dastcvi/cutdown_hardware/README.md

# cutdown_hardware
Hardware files for the LASP high altitude balloon cutdown controller

## Versions
Different hardware revisions are tagged appropriately and can be downloaded directly from the GitHub Releases tab.
