dastcvi/cutdown_hardware/cutdown_schematic.pdf

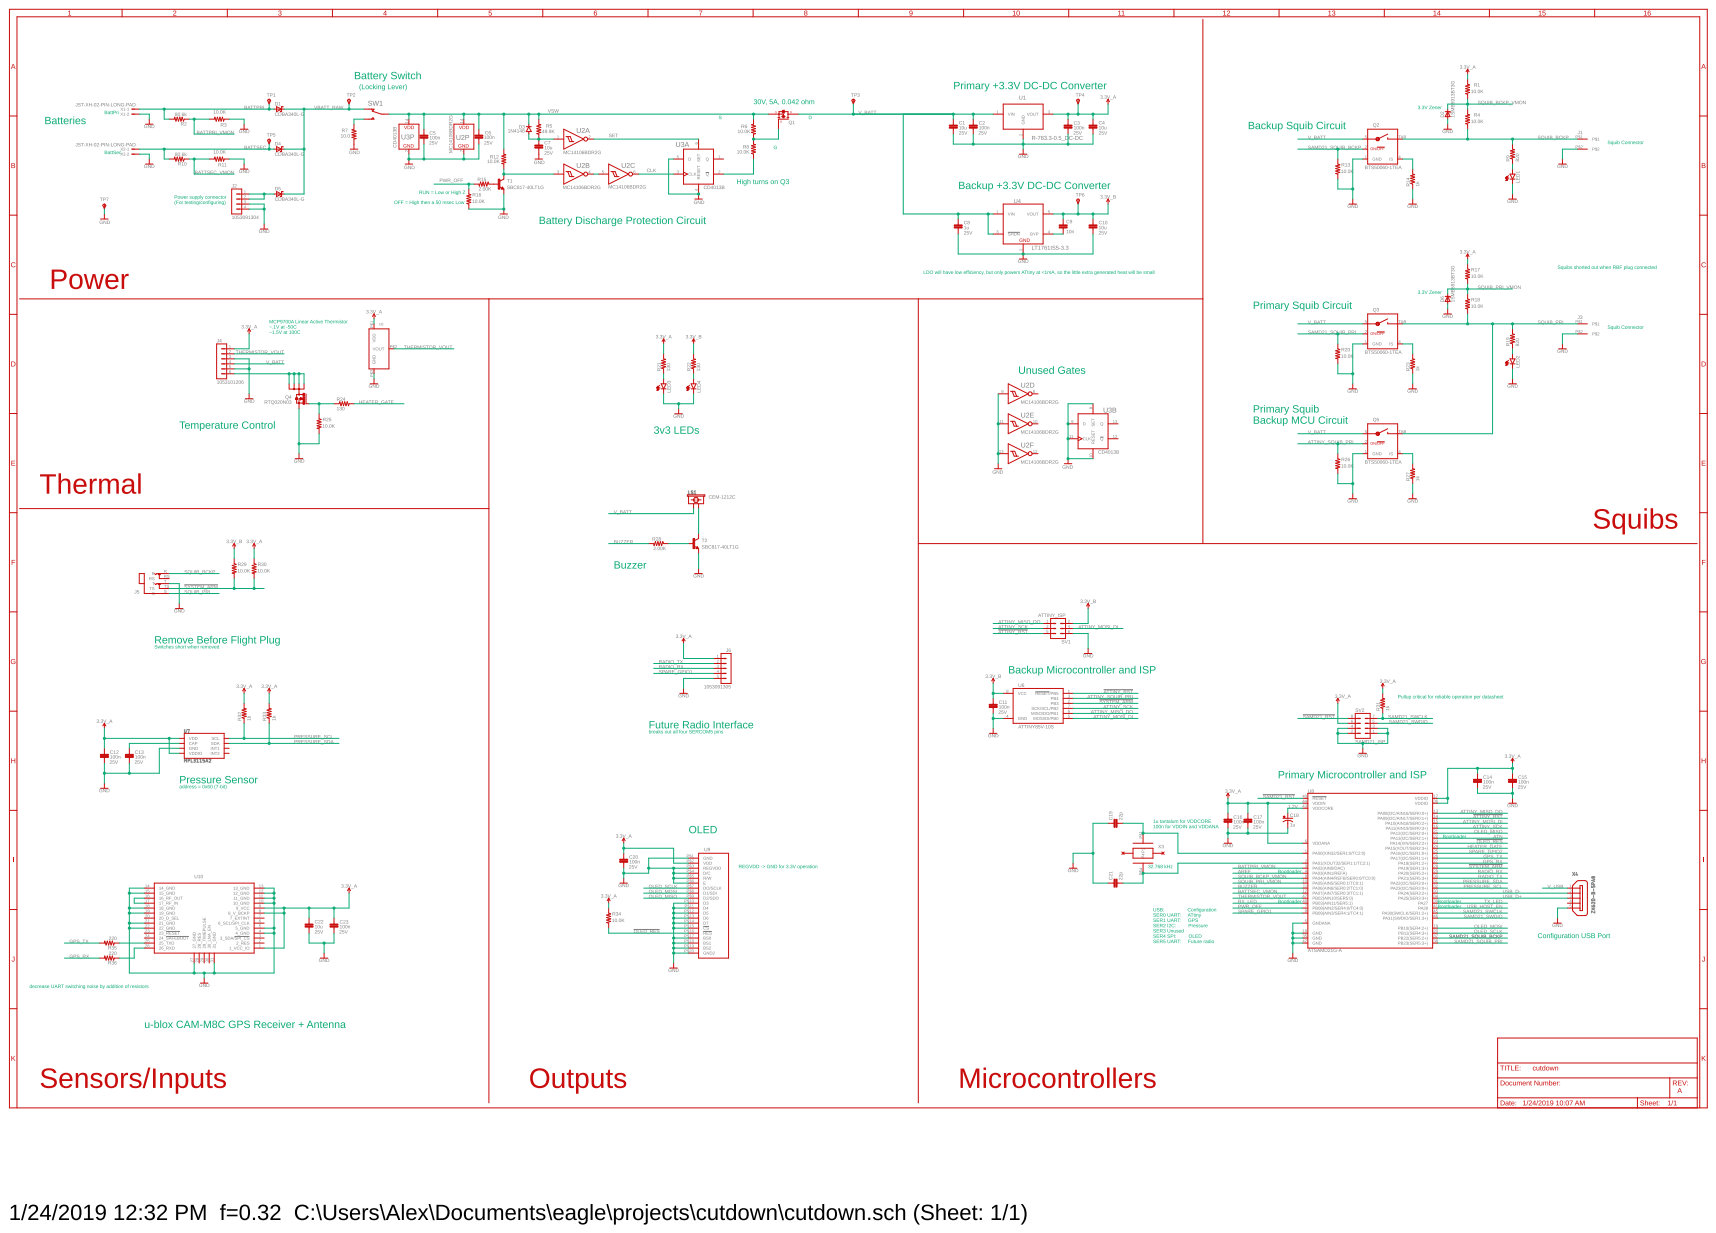
[picture p1: page 1]
