dastcvi/cutdown_hardware/cutdown_layout.pdf

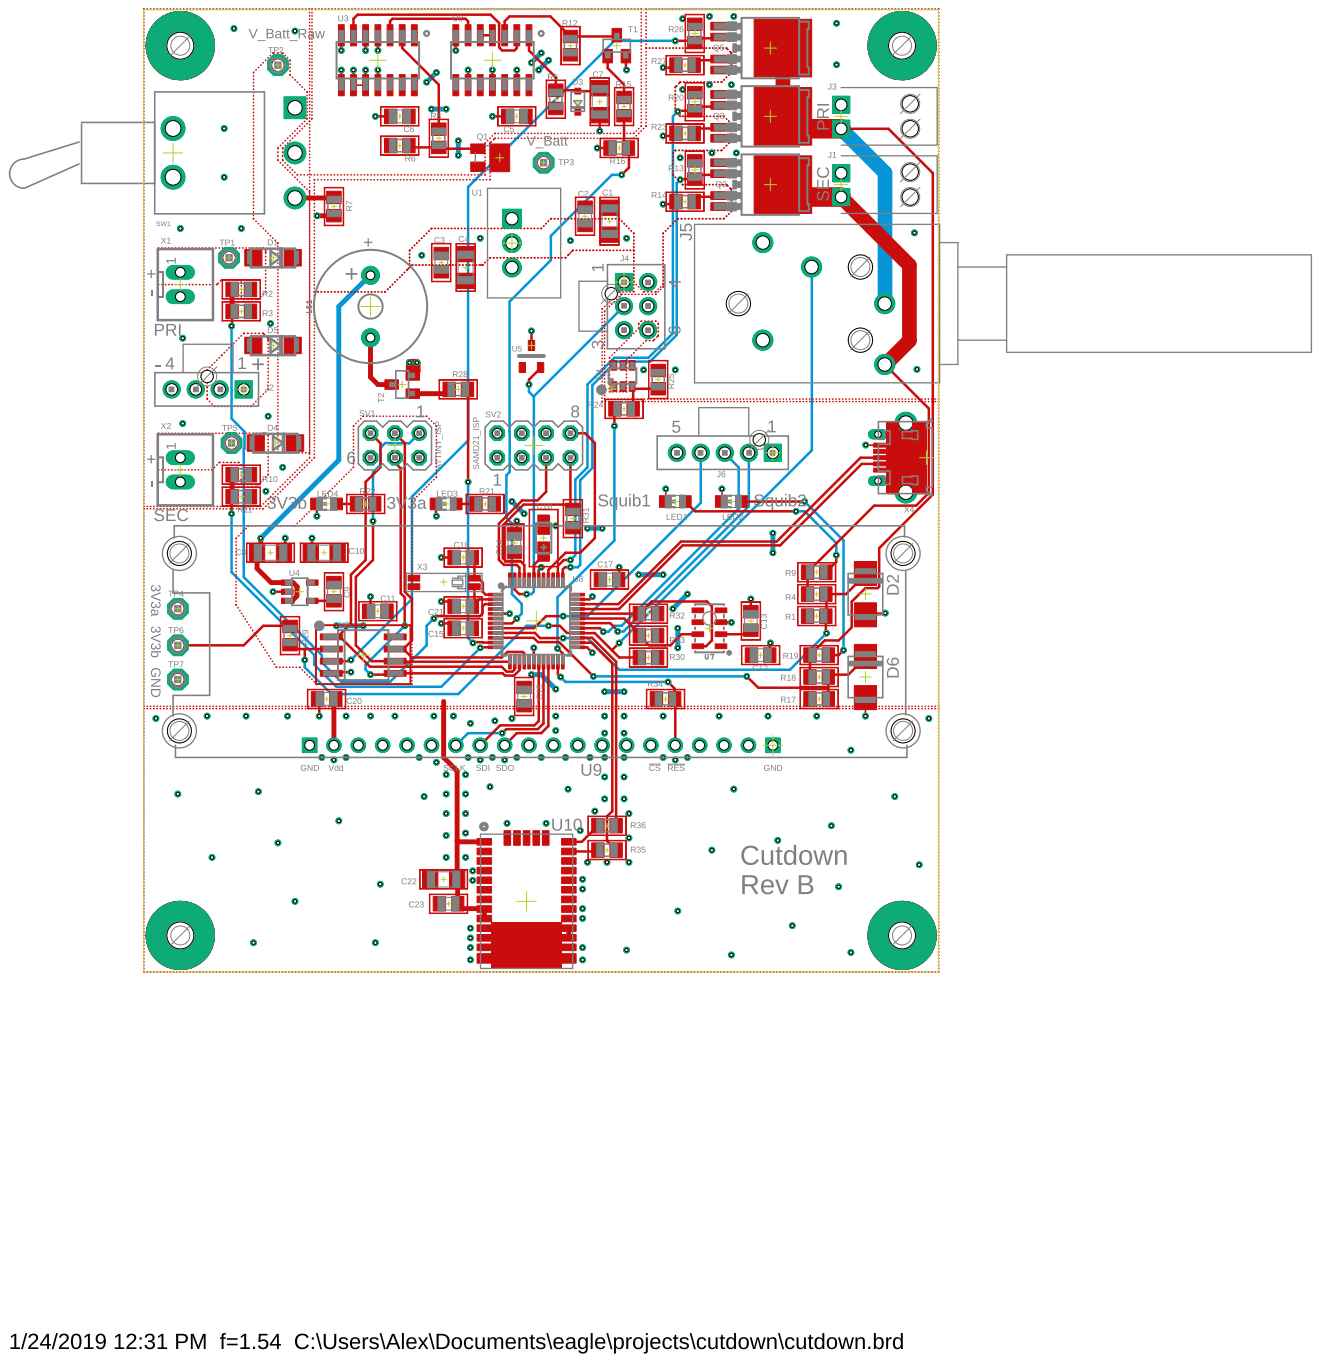
[picture p2: page 1]
