dastcvi/cutdown_hardware/cutdown.brd

## EAGLE design cutdown.brd (2020-07-08)

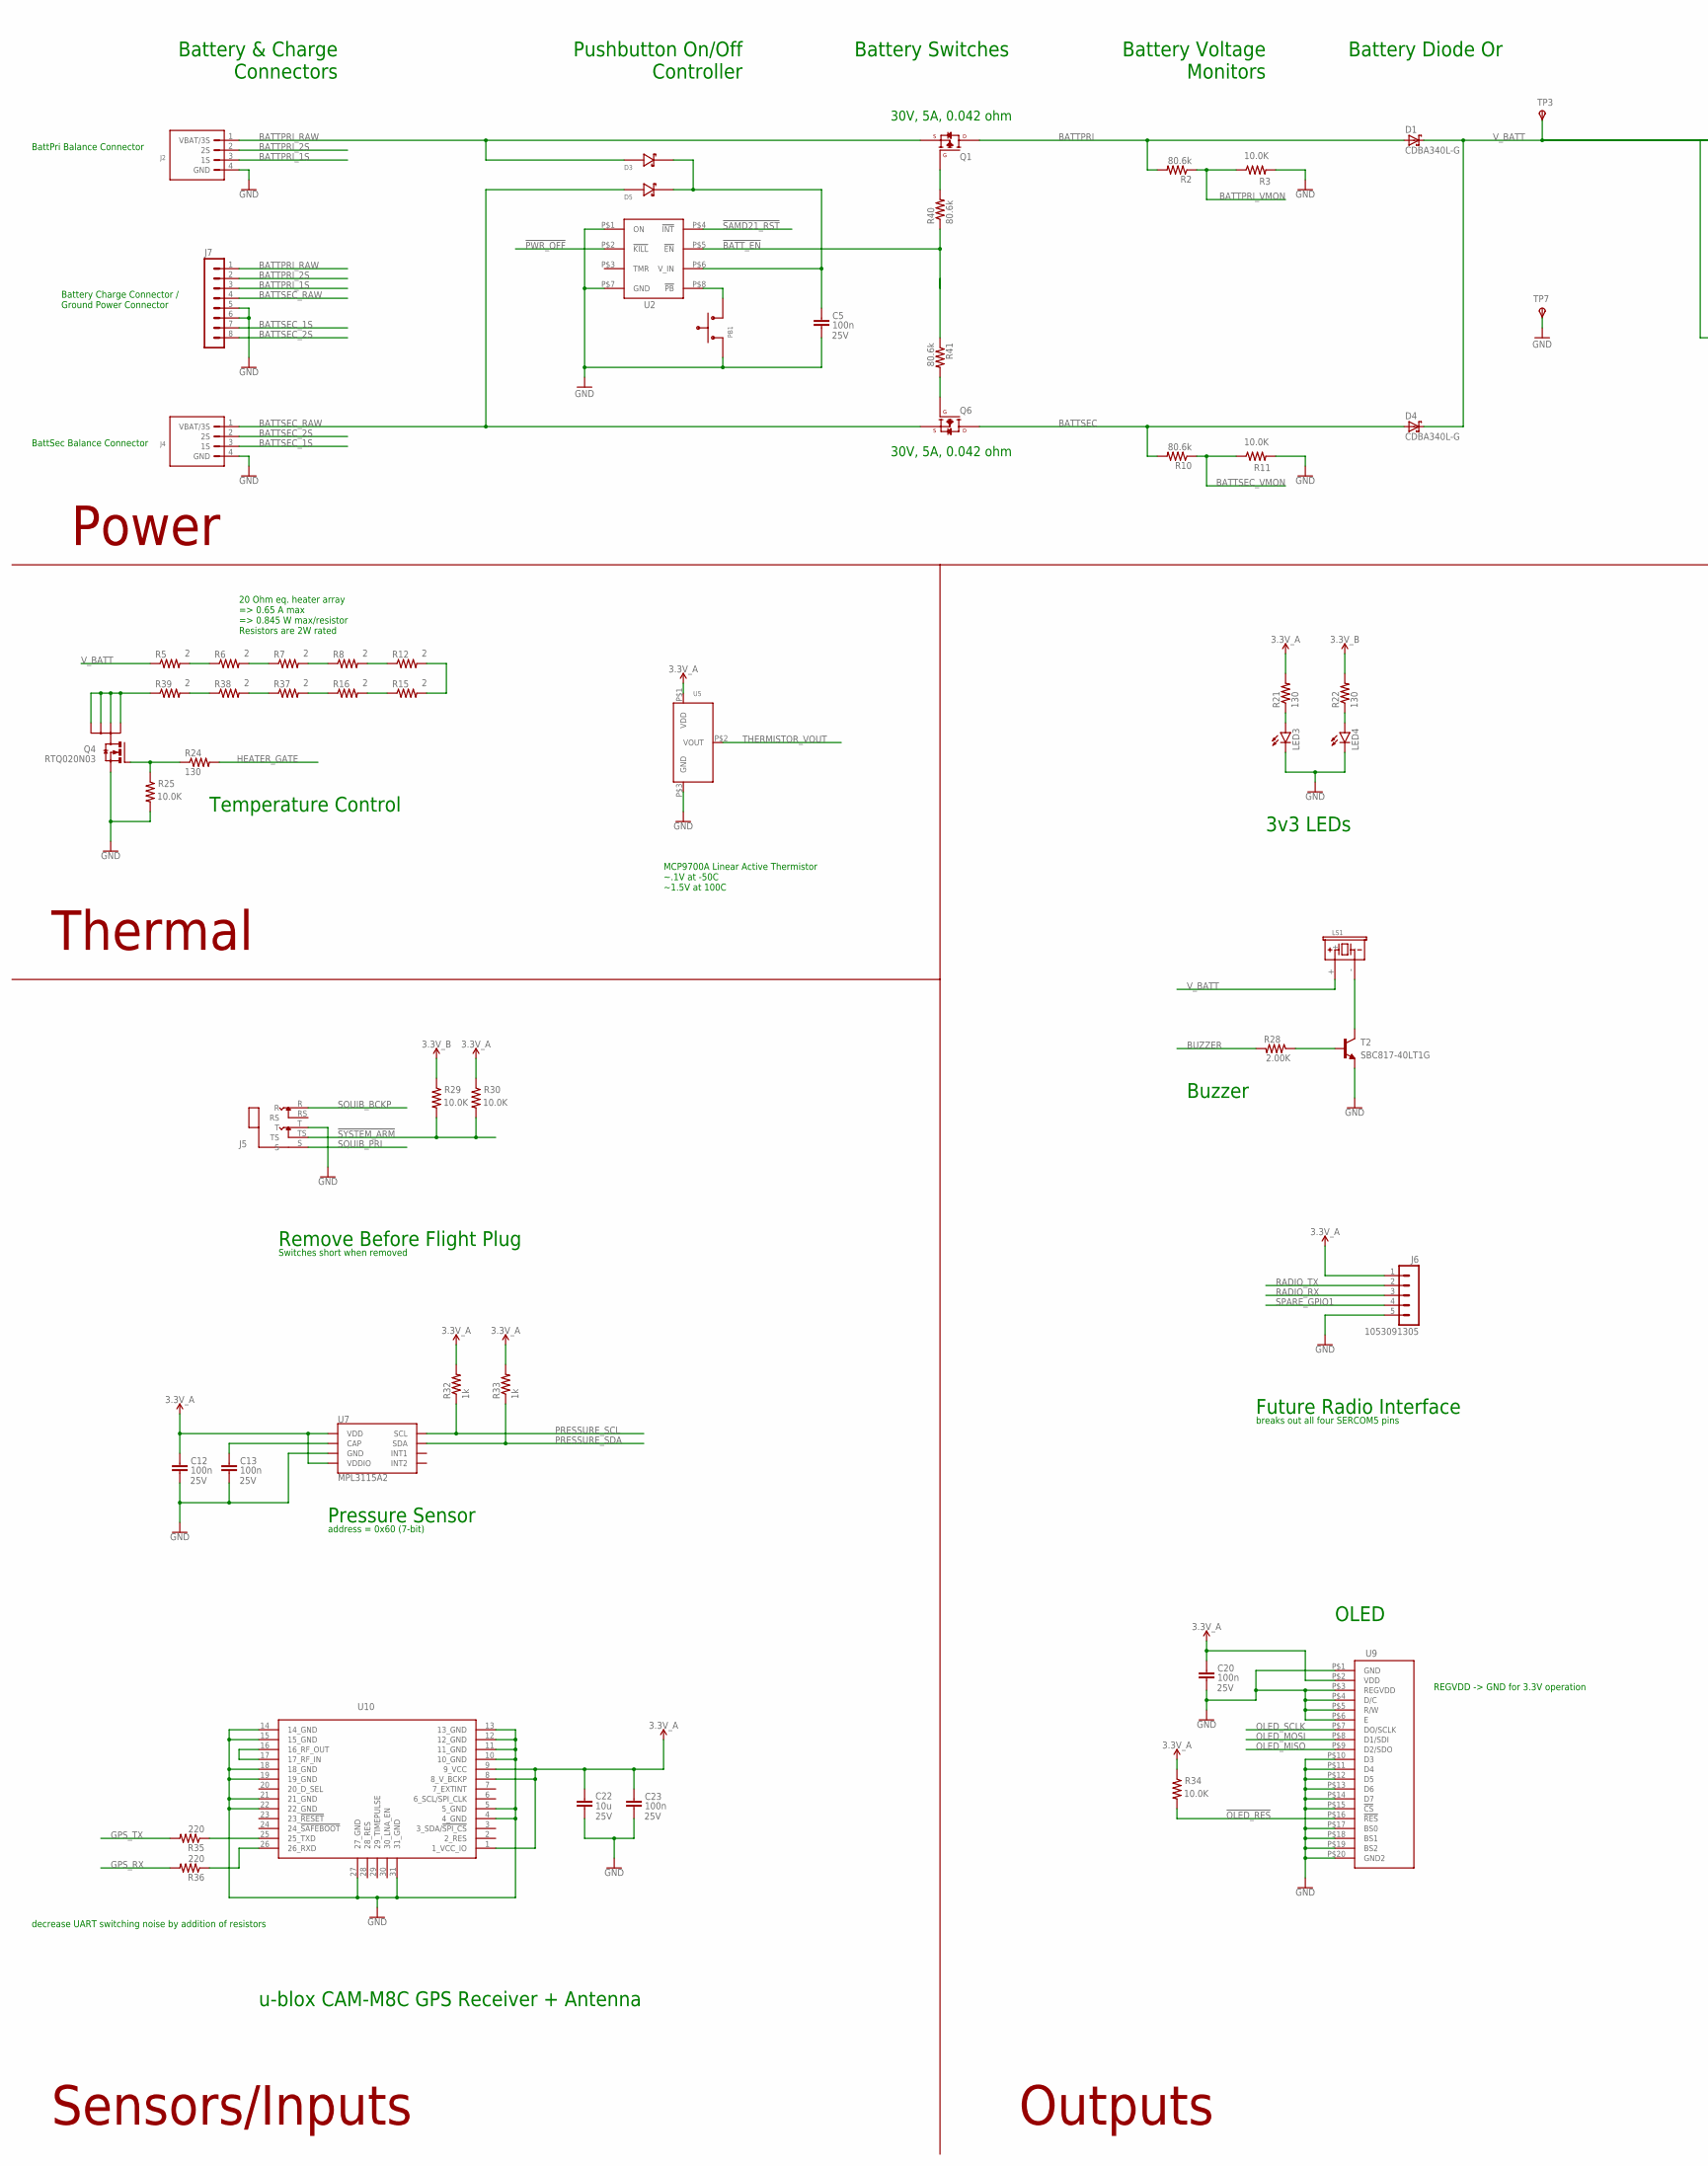
[picture p3: schematic cutdown.sch, part in row 1, column 1]

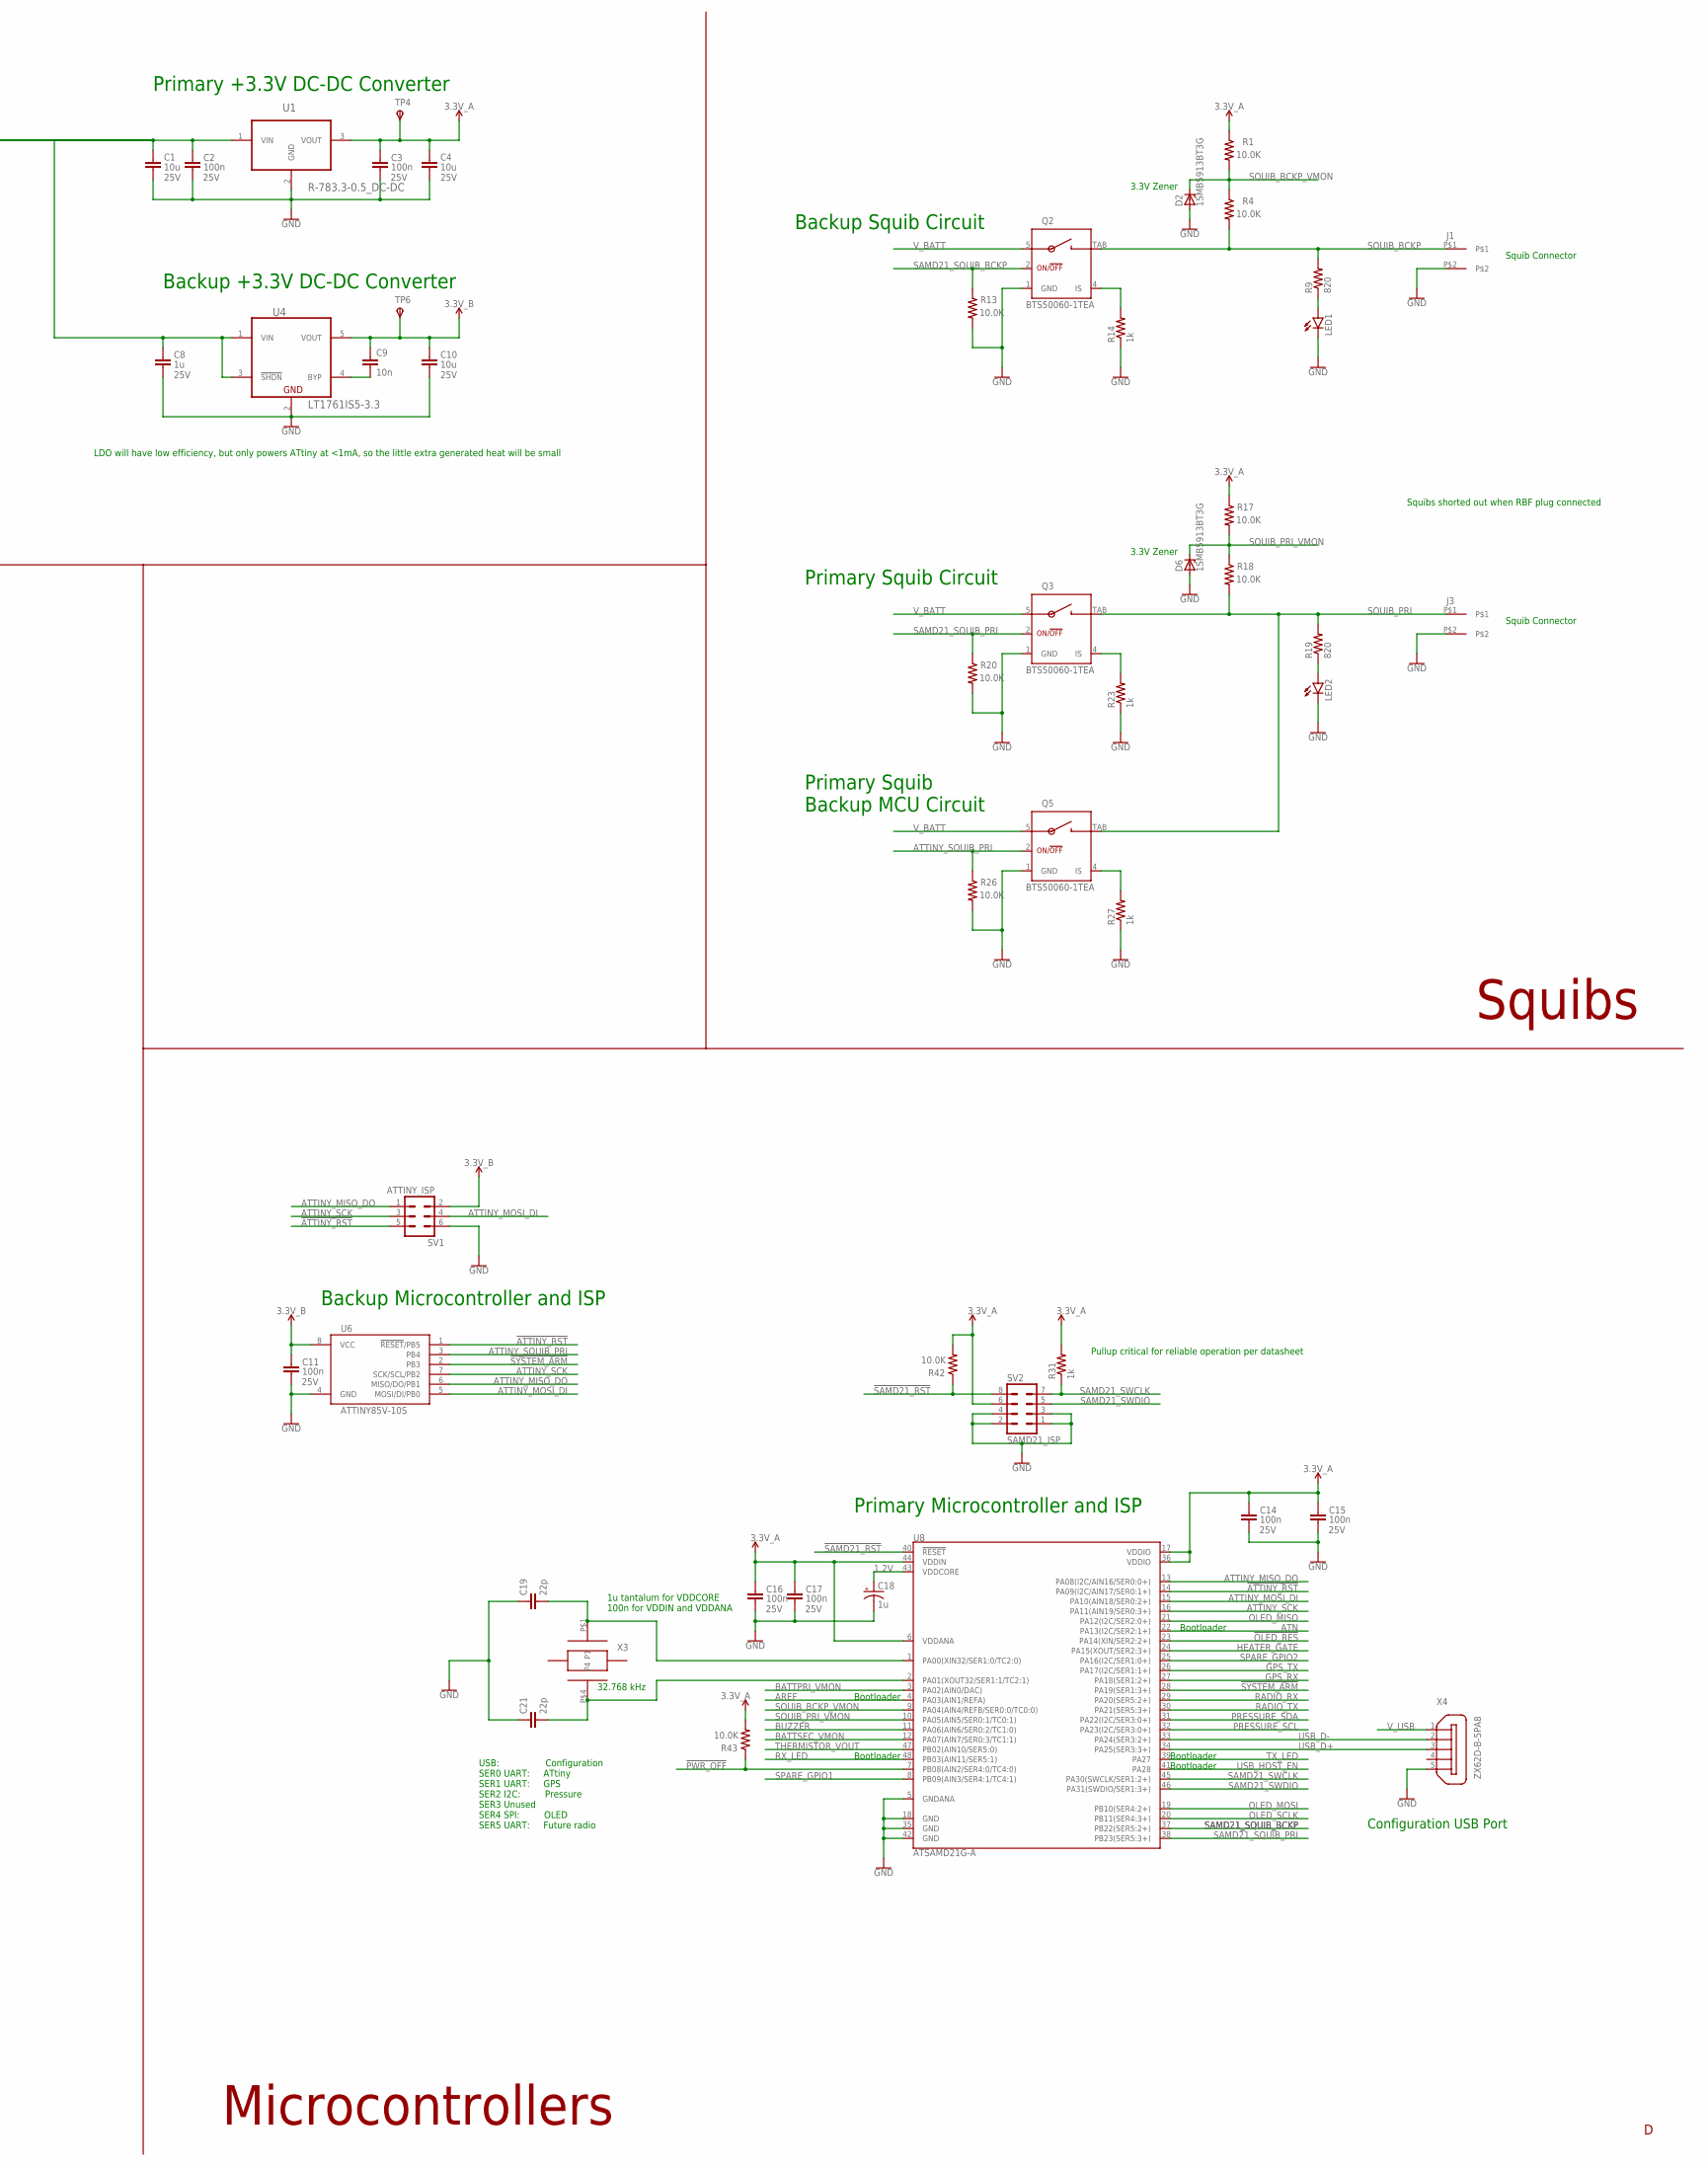
[picture p4: schematic cutdown.sch, part in row 1, column 2]

Parts:
C1, C4, C10, C22: 10u; C1206; VOLTAGE 25V; MFG_PN CL31B106KAHZW6E
C2, C3, C5, C11, C12, C13, C14, C15, C16, C17, C20, C23: 100n; C0805; VOLTAGE 25V; MFG_PN 08053C104KAT2A
C8: 1u; C1206; VOLTAGE 25V; MFG_PN C1206C105K3RACTU
C9: 10n; C0805; MFG_PN C0805C103K5RACTU
C18: 1u; CT3216; MFG_PN T491A105K016AT
C19, C21: 22p; C0805; MFG_PN C0805C220K5GACTU
D1, D4: CDBA340L-G; DO214AC
D2, D6: 1SMB5913BT3G; DO214AA
D3, D5: BAT54HT1G; MFG_PN BAT54HT1G
J1, J3: DECTOR_PARTS_TR_NANOFIT_1X2_RA; DECTOR_PARTS_TR_NANOFIT_1X2_RIGHTANGLE
J2, J4: S4B-XH-SM4-TB-3S-BALANCE; S4B-XH-SM4-TB; MFG_PN S4B-XH-SM4-TB(LF)(SN)
J5: RN114BPC; MFG_PN RN114BPC
J6: 1053091305
J7: 1053141208; MFG_PN 1053141208
LED1, LED2: LEDCHIP-LED0805; CHIP-LED0805; MFG_PN LTST-C171KRKT
LED3, LED4: LEDCHIP-LED0805; CHIP-LED0805; MFG_PN LTST-C171GKT
LS1: CEM-1212C; MFG_PN CEM-1212C
PB1: FP11SPA1B1TP03; MFG_PN FP11SPA1B1TP03
Q1, Q6: SI2347DS-T1-GE3; SI1247DS; MFG_PN SI2347DS-T1-GE3
Q2, Q3, Q5: BTS50060-1TEA; PG-TO252-5-11
Q4: RTQ020N03; SC-95(TSMT6)
R1, R3, R4, R11, R13, R17, R18, R20, R25, R26, R29, R30, R34, R42, R43: 10.0K; R0805; MFG_PN ERJ-6ENF1002V
R2, R10, R40, R41: 80.6k; R0805; MFG_PN ERJ-6ENF8062V
R5, R6, R7, R8, R12, R15, R16, R37, R38, R39: 2; R2512; MFG_PN CRM2512-JW-2R0ELF
R9, R19: 820; R0805; MFG_PN ERJ-6ENF8200V
R14, R23, R27, R31, R32, R33: 1k; R0805; MFG_PN ERJ-6ENF1001V
R21, R22, R24: 130; R0805; MFG_PN ERJ-6ENF1300V
R28: 2.00K; R0805; MFG_PN ERJ-6ENF2001V
R35, R36: 220; R0805; MFG_PN ERJ-6ENF2200V
SV1: ATTINY_ISP; MA03-2; MFG_PN 67996-406HLF
SV2: SAMD21_ISP; MA04-2; MFG_PN 67996-408HLF
T2: SBC817-40LT1G; SOT23; MFG_PN SBC817-40LT1G
TP3, TP4, TP6: TPSPAD1-13; P1-13
TP7: TPSPAD1-13; P1-13; MFG_PN 5001
U1: R-783.3-0.5_DC-DC; R-783P3-0P5_DC-DC
U2: LTC2955ITS8-2; LTC2955_TSOT-8; MFG_PN LTC2955ITS8-2#TRMPBF
U4: LT1761IS5-3.3; TSOT23-5; MFG_PN LT1761IS5-3.3#TRMPBF
U5: MCP9700T-E/TT; MFG_PN MCP9700T-E/TT
U6: ATTINY85V-10S; SOIC8_EIAJ_208MIL
U7: MPL3115A2; LGA-8-5X3; MFG_PN MPL3115A2
U8: ATSAMD21G-A; TQFP-48
U9: NHD-0216CW-AW3
U10: CAM-M8C-0; CAM_M8C; MFG_PN CAM-M8C-0
X3: MC-146-32.7680KA-A0; MC-146
X4: ZX62D-B-5PA8

Connections:
1.2V: C18.+, U8.43 (VDDCORE)
!ATTINY_RST!: SV1.5, U6.1 (!RESET!/PB5), U8.14 (PA09(I2C/AIN17/SER0:1+))
!BATT_EN: R40.1, R41.1, U2.P$5 (!EN)
!OLED_RES!: R34.2, U8.23 (PA14(XIN/SER2:2+)), U9.P$16 (!RES!)
!PWR_OFF!: R43.1, U2.P$2 (!KILL), U8.7 (PB08(AIN2/SER4:0/TC4:0))
!SAMD21_RST!: R42.1, SV2.8, U2.P$4 (!INT), U8.40 (!RESET!)
!SYSTEM_ARM!: J5.TS, R29.2, R30.2, U6.2 (PB3), U8.28 (PA19(SER1:3+))
AREF: U8.4 (PA03(AIN1/REFA))
ATN: U8.22 (PA13(I2C/SER2:1+))
ATTINY_MISO_DO: SV1.1, U6.6 (MISO/DO/PB1), U8.13 (PA08(I2C/AIN16/SER0:0+))
ATTINY_MOSI_DI: SV1.4, U6.5 (MOSI/DI/PB0), U8.15 (PA10(AIN18/SER0:2+))
ATTINY_SCK: SV1.3, U6.7 (SCK/SCL/PB2), U8.16 (PA11(AIN19/SER0:3+))
ATTINY_SQUIB_PRI: Q5.2 (IN), R26.1, U6.3 (PB4)
BATTPRI: D1.A, Q1.D, R2.2
BATTPRI_1S: J2.3 (1S), J7.3
BATTPRI_2S: J2.2 (2S), J7.2
BATTPRI_RAW: D3.A, J2.1 (VBAT/3S), J7.1, Q1.S
BATTPRI_VMON: R2.1, R3.1, U8.3 (PA02(AIN0/DAC))
BATTSEC: D4.A, Q6.D, R10.2
BATTSEC_1S: J4.3 (1S), J7.7
BATTSEC_2S: J4.2 (2S), J7.8
BATTSEC_RAW: D5.A, J4.1 (VBAT/3S), J7.4, Q6.S
BATTSEC_VMON: R10.1, R11.1, U8.12 (PA07(AIN7/SER0:3/TC1:1))
BUZZER: R28.2, U8.11 (PA06(AIN6/SER0:2/TC1:0))
GND: C1.2, C2.2, C3.2, C4.2, C5.2, C8.2, C10.2, C11.2, C12.2, C13.2, C14.2, C15.2, C16.2, C17.2, C18.-, C19.1, C20.2, C21.1, C22.2, C23.2, D2.A, D6.A, J1.P$2, J2.4 (GND), J3.P$2, J4.4 (GND), J5.T, J6.5, J7.5, J7.6, LED1.C, LED2.C, LED3.C, LED4.C, PB1.1, Q2.1 (GND), Q3.1 (GND), Q4.4 (S), Q5.1 (GND), R3.2, R11.2, R13.2, R14.1, R20.2, R23.1, R25.2, R26.2, R27.1, SV1.6, SV2.1, SV2.2, SV2.3, SV2.4, T2.2 (E), TP7.TP, U1.2 (GND), U2.P$1 (ON), U2.P$7 (GND), U4.2 (GND), U5.P$3 (GND), U6.4 (GND), U7.3 (GND), U8.5 (GNDANA), U8.18 (GND), U8.35 (GND), U8.42 (GND), U9.P$1 (GND), U9.P$3 (REGVDD), U9.P$4 (D/C), U9.P$5 (R/W), U9.P$6 (E), U9.P$10 (D3), U9.P$11 (D4), U9.P$12 (D5), U9.P$13 (D6), U9.P$14 (D7), U9.P$15 (!CS!), U9.P$17 (BS0), U9.P$18 (BS1), U9.P$19 (BS2), U9.P$20 (GND2), U10.4 (4_GND), U10.5 (5_GND), U10.10 (10_GND), U10.11 (11_GND), U10.12 (12_GND), U10.13 (13_GND), U10.14 (14_GND), U10.15 (15_GND), U10.18 (18_GND), U10.19 (19_GND), U10.21 (21_GND), U10.22 (22_GND), U10.27 (27_GND), U10.31 (31_GND), X4.5
GPS_RX: R36.2, U8.27 (PA18(SER1:2+))
GPS_TX: R35.2, U8.26 (PA17(I2C/SER1:1+))
HEATER_GATE: R24.2, U8.24 (PA15(XOUT/SER2:3+))
unnamed: R28.1, T2.1 (B)
unnamed: R5.2, R6.1
unnamed: Q1.G, R40.2
unnamed: R6.2, R7.1
unnamed: R7.2, R8.1
unnamed: R8.2, R12.1
unnamed: R12.2, R15.2
unnamed: C13.1, U7.2 (CAP)
unnamed: U10.16 (16_RF_OUT), U10.17 (17_RF_IN)
unnamed: R35.1, U10.25 (25_TXD)
unnamed: C21.2, U8.2 (PA01(XOUT32/SER1:1/TC2:1)), X3.P$4 (P4)
unnamed: LED3.A, R21.1
unnamed: Q2.4 (IS), R14.2
unnamed: LED4.A, R22.1
unnamed: LED1.A, R9.1
unnamed: R15.1, R16.2
unnamed: R16.1, R37.2
unnamed: Q3.4 (IS), R23.2
unnamed: Q5.4 (IS), R27.2
unnamed: LED2.A, R19.1
unnamed: R37.1, R38.2
unnamed: Q4.3 (G), R24.1, R25.1
unnamed: C19.2, U8.1 (PA00(XIN32/SER1:0/TC2:0)), X3.P$1 (P1)
unnamed: R38.1, R39.2
unnamed: LS1.-, T2.3 (C)
unnamed: C9.2, U4.4 (BYP)
unnamed: R36.1, U10.26 (26_RXD)
unnamed: Q4.1 (D), Q4.2 (D), Q4.5 (D), Q4.6 (D6), R39.1
unnamed: Q6.G, R41.2
unnamed: PB1.3, U2.P$8 (!PB)
unnamed: C5.1, D3.C, D5.C, U2.P$6 (V_IN)
OLED_MISO: U8.21 (PA12(I2C/SER2:0+)), U9.P$9 (D2/SDO)
OLED_MOSI: U8.19 (PB10(SER4:2+)), U9.P$8 (D1/SDI)
OLED_SCLK: U8.20 (PB11(SER4:3+)), U9.P$7 (DO/SCLK)
PRESSURE_SCL: R32.1, U7.8 (SCL), U8.32 (PA23(I2C/SER3:0+))
PRESSURE_SDA: R33.1, U7.7 (SDA), U8.31 (PA22(I2C/SER3:0+))
RADIO_RX: J6.3, U8.29 (PA20(SER5:2+))
RADIO_TX: J6.2, U8.30 (PA21(SER5:3+))
RX_LED: U8.48 (PB03(AIN11/SER5:1))
SAMD21_SQUIB_BCKP: Q2.2 (IN), R13.1, U8.37 (PB22(SER5:2+))
SAMD21_SQUIB_PRI: Q3.2 (IN), R20.1, U8.38 (PB23(SER5:3+))
SAMD21_SWCLK: R31.1, SV2.7, U8.45 (PA30(SWCLK/SER1:2+))
SAMD21_SWDIO: SV2.5, U8.46 (PA31(SWDIO/SER1:3+))
SPARE_GPIO1: J6.4, U8.8 (PB09(AIN3/SER4:1/TC4:1))
SPARE_GPIO2: U8.25 (PA16(I2C/SER1:0+))
SQUIB_BCKP: J1.P$1, J5.R, Q2.TAB (OUT), R4.2, R9.2
SQUIB_BCKP_VMON: D2.C, R1.2, R4.1, U8.9 (PA04(AIN4/REFB/SER0:0/TC0:0))
SQUIB_PRI: J3.P$1, J5.S, Q3.TAB (OUT), Q5.TAB (OUT), R18.2, R19.2
SQUIB_PRI_VMON: D6.C, R17.2, R18.1, U8.10 (PA05(AIN5/SER0:1/TC0:1))
THERMISTOR_VOUT: U5.P$2 (VOUT), U8.47 (PB02(AIN10/SER5:0))
TX_LED: U8.39 (PA27)
USB_D+: U8.34 (PA25(SER3:3+)), X4.3
USB_D-: U8.33 (PA24(SER3:2+)), X4.2
USB_HOST_EN: U8.41 (PA28)
VCC_1: C3.1, C4.1, C12.1, C14.1, C15.1, C16.1, C17.1, C20.1, C22.1, C23.1, J6.1, R1.1, R17.1, R21.2, R30.1, R31.2, R32.2, R33.2, R34.1, R42.2, R43.2, SV2.6, TP4.TP, U1.3 (VOUT), U5.P$1 (VDD), U7.1 (VDD), U7.4 (VDDIO), U8.6 (VDDANA), U8.17 (VDDIO), U8.36 (VDDIO), U8.44 (VDDIN), U9.P$2 (VDD), U10.1 (1_VCC_IO), U10.8 (8_V_BCKP), U10.9 (9_VCC)
VCC_2: C9.1, C10.1, C11.1, R22.2, R29.1, SV1.2, TP6.TP, U4.5 (VOUT), U6.8 (VCC)
V_BATT: C1.1, C2.1, C8.1, D1.C, D4.C, LS1.+, Q2.5 (VS), Q3.5 (VS), Q5.5 (VS), R5.1, TP3.TP, U1.1 (VIN), U4.1 (VIN), U4.3 (!SHDN)
V_USB: X4.1

Notes on the sheet:
Backup Microcontroller and ISP
Primary Microcontroller and ISP
1u tantalum for VDDCORE 100n for VDDIN and VDDANA
BattPri Balance Connector
Primary +3.3V DC-DC Converter
Backup +3.3V DC-DC Converter
Pullup critical for reliable operation per datasheet
Configuration USB Port
u-blox CAM-M8C GPS Receiver + Antenna
Pressure Sensor
USB: Configuration SER0 UART: ATtiny SER1 UART: GPS SER2 I2C: Pressure SER3 Unused SER4 SPI: OLED SER5 UART: Future radio
BattSec Balance Connector
Battery & Charge Connectors
address = 0x60 (7-bit)
OLED
Remove Before Flight Plug
Switches short when removed
3.3V Zener
Backup Squib Circuit
Primary Squib Circuit
Primary Squib Backup MCU Circuit
Temperature Control
Future Radio Interface
breaks out all four SERCOM5 pins
32.768 kHz
30V, 5A, 0.042 ohm
3v3 LEDs
Squib Connector
Buzzer
MCP9700A Linear Active Thermistor ~.1V at -50C ~1.5V at 100C
Power
Squibs
Microcontrollers
Outputs
Sensors/Inputs
Thermal
Squibs shorted out when RBF plug connected
REGVDD -> GND for 3.3V operation
Bootloader
LDO will have low efficiency, but only powers ATtiny at <1mA, so the little extra generated heat will be small
decrease UART switching noise by addition of resistors
20 Ohm eq. heater array => 0.65 A max => 0.845 W max/resistor Resistors are 2W rated
Battery Charge Connector / Ground Power Connector
Pushbutton On/Off Controller
Battery Switches
Battery Voltage Monitors
Battery Diode Or

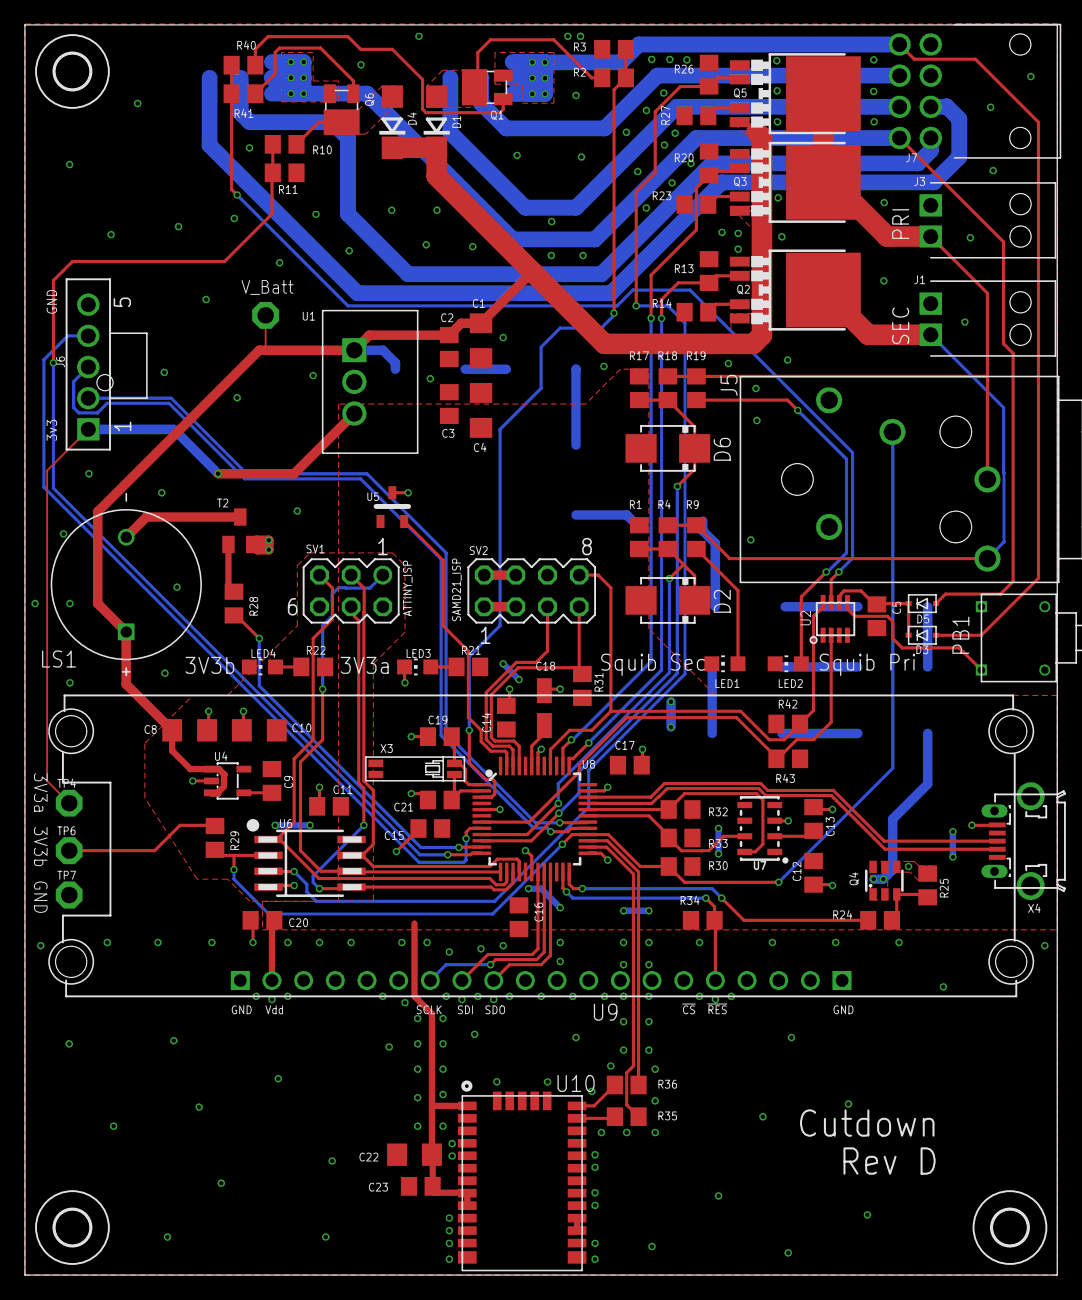
[picture p5: board cutdown.brd from above]

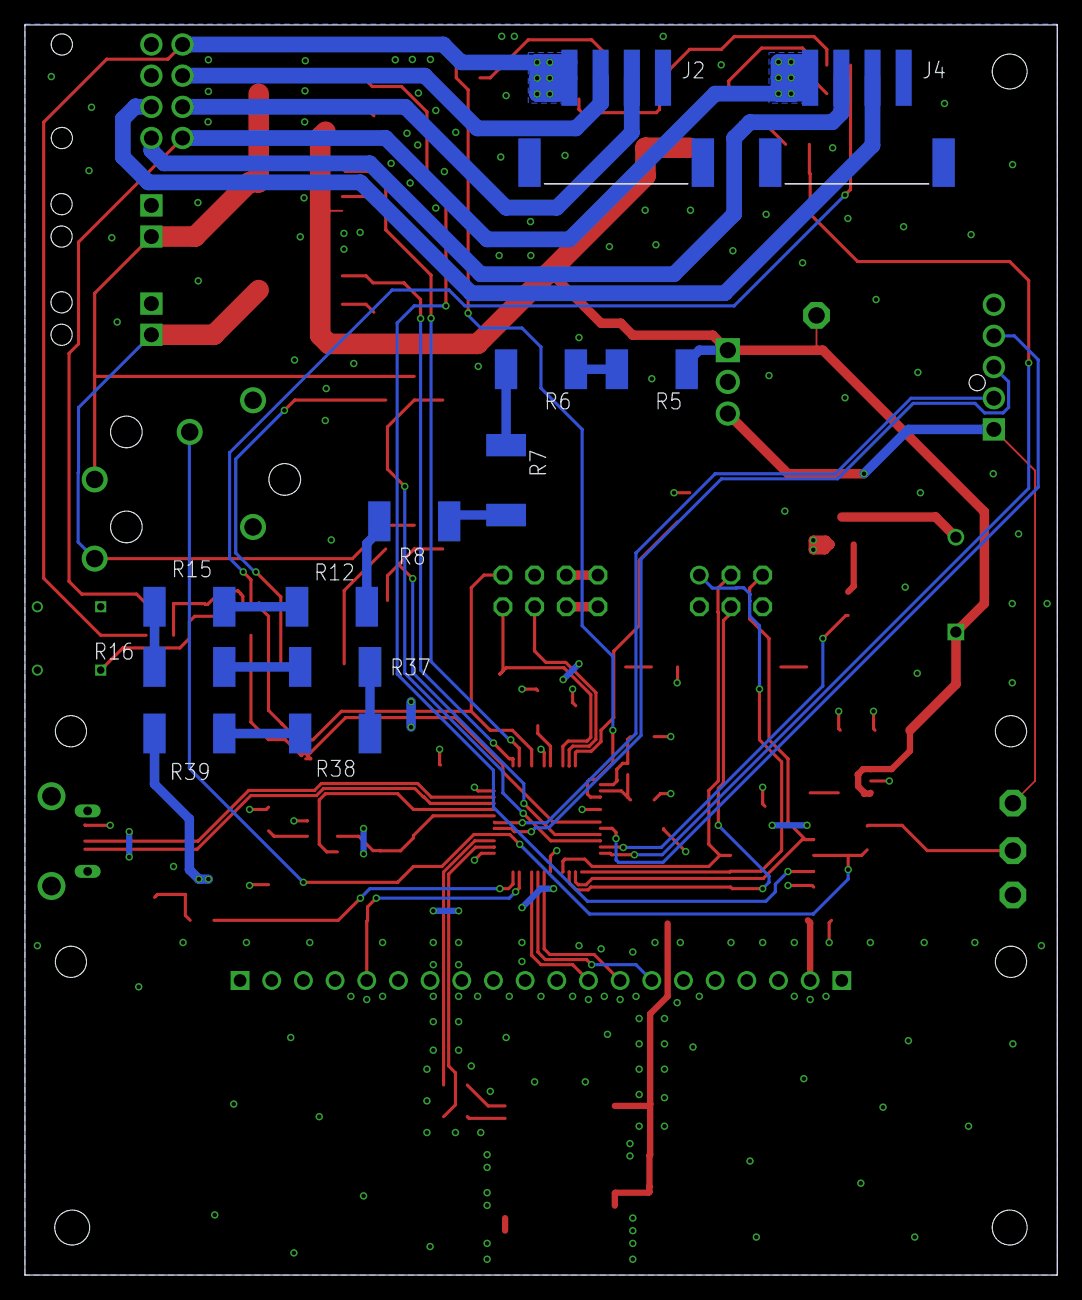
[picture p6: board cutdown.brd from below]

Board: 2 copper layers, 82.8 x 100.3 mm, 110 parts (12 on the bottom side), 79 nets.

Other parts of the board:
U$16, U$17, U$18: 2,8
