dastcvi/cutdown_hardware/(commit log)

2018-12-04 Added Rev A files
    [cutdown.brd, cutdown.sch, revA_bom_digikey.csv]
2019-01-24 Rev B Hardware
    [cutdown.brd, cutdown.sch, revB_bom.csv]
2020-07-08 Rev D files
    [cutdown.brd, cutdown.sch, cutdown_revD_bom.csv]
